bw2012/pk-hobbit/docs/sys/03.gif

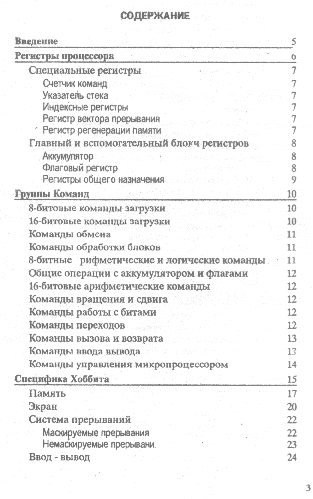
docs/sys/03.gif
