bw2012/pk-hobbit/docs/sys/04_05.gif

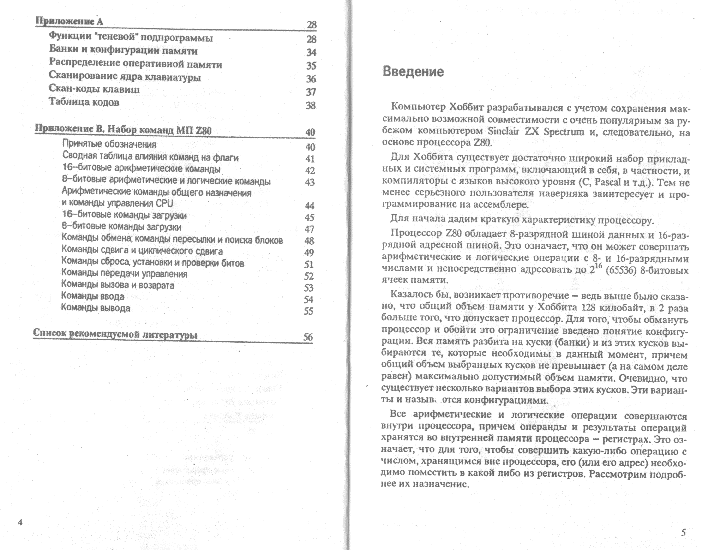
docs/sys/04_05.gif
