bw2012/pk-hobbit/docs/sys/06_07.gif

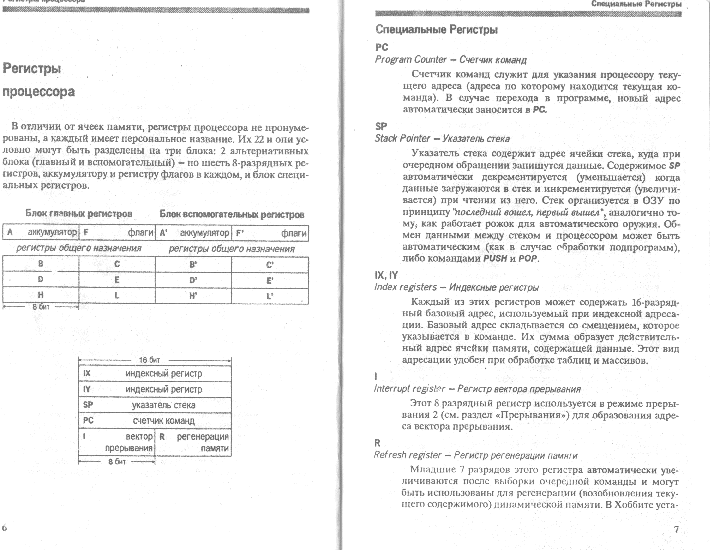
docs/sys/06_07.gif
