bw2012/pk-hobbit/docs/sys/08_09.gif

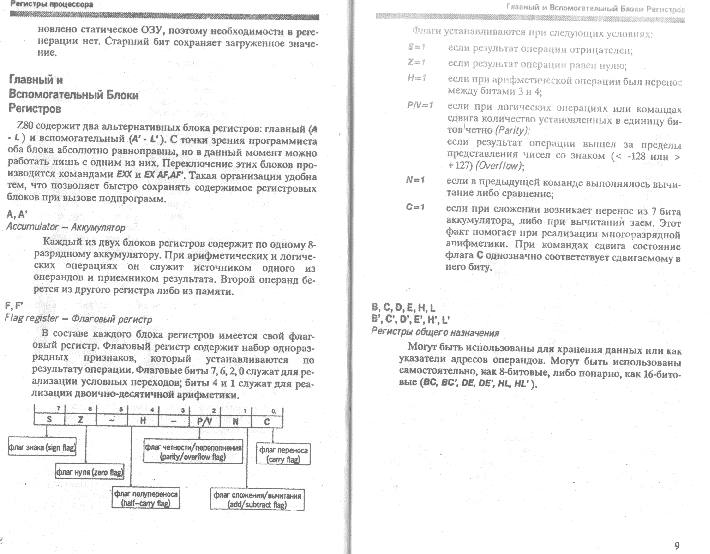
docs/sys/08_09.gif
