bw2012/pk-hobbit/docs/sys/10_11.gif

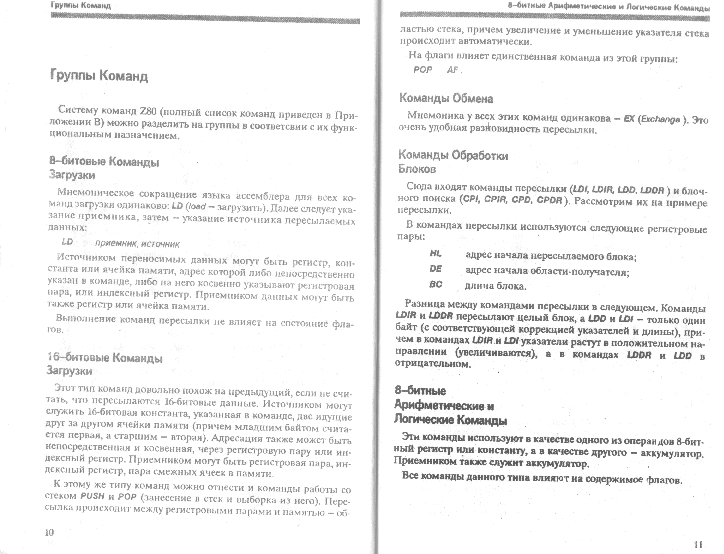
docs/sys/10_11.gif
