bw2012/pk-hobbit/docs/sys/12_13.gif

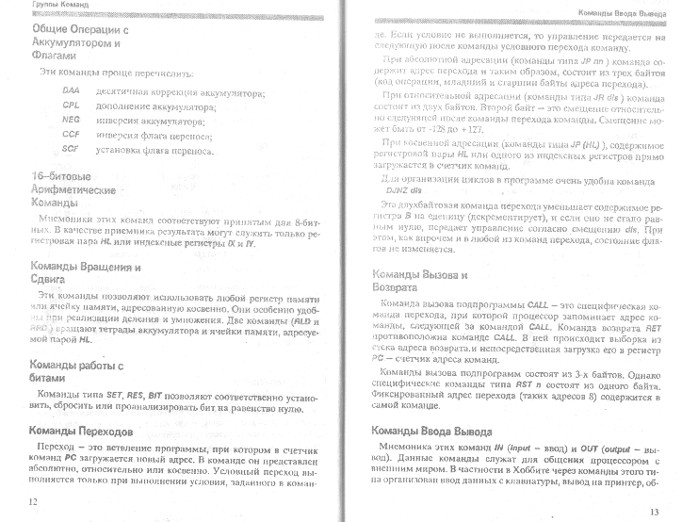
docs/sys/12_13.gif
