bw2012/pk-hobbit/docs/sys/14_15.gif

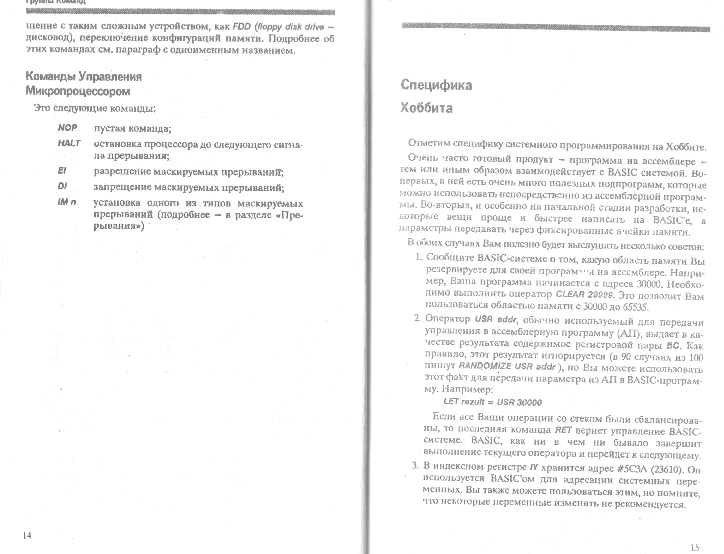
docs/sys/14_15.gif
