bw2012/pk-hobbit/docs/sys/16_17.gif

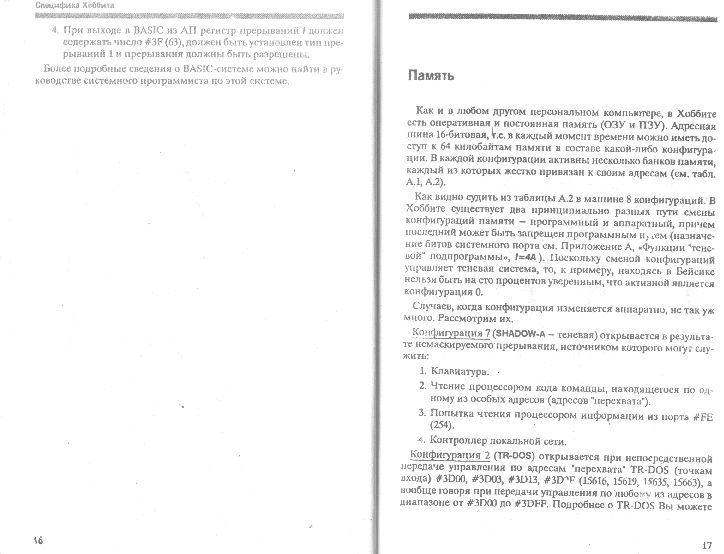
docs/sys/16_17.gif
