bw2012/pk-hobbit/docs/sys/18_19.gif

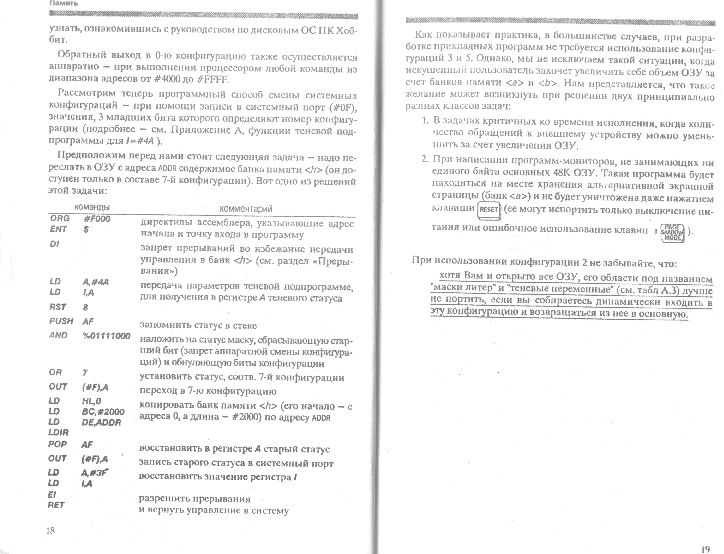
docs/sys/18_19.gif
