bw2012/pk-hobbit/docs/sys/20_21.gif

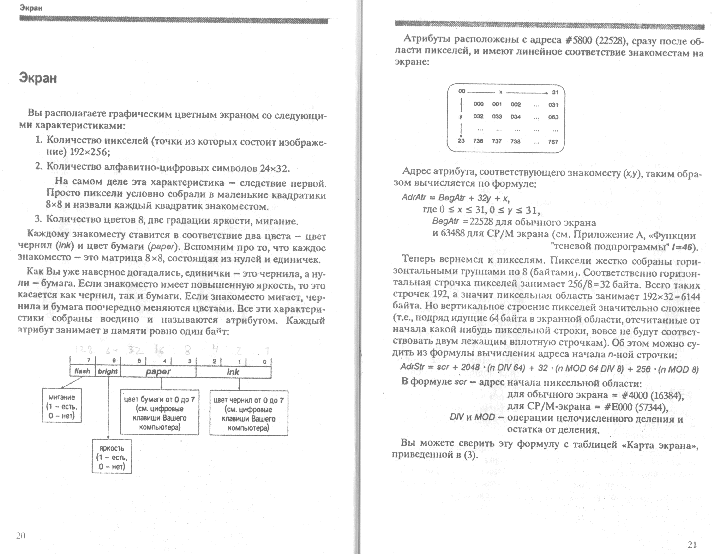
docs/sys/20_21.gif
