bw2012/pk-hobbit/docs/sys/22_23.gif

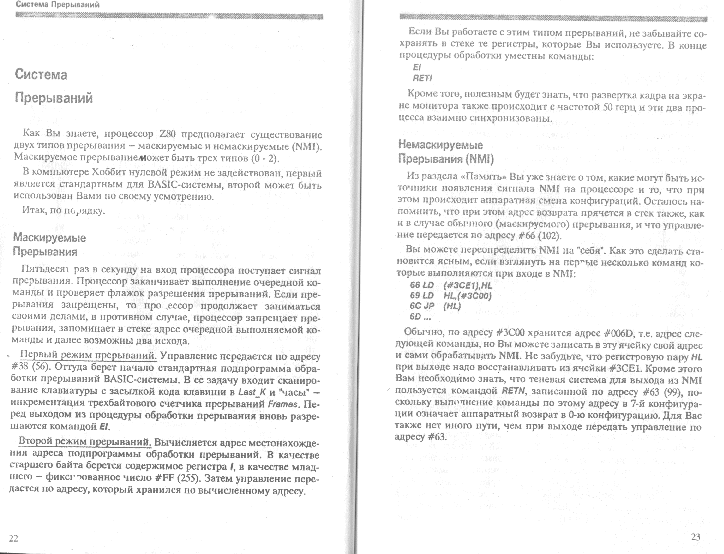
docs/sys/22_23.gif
