bw2012/pk-hobbit/docs/sys/24_25.gif

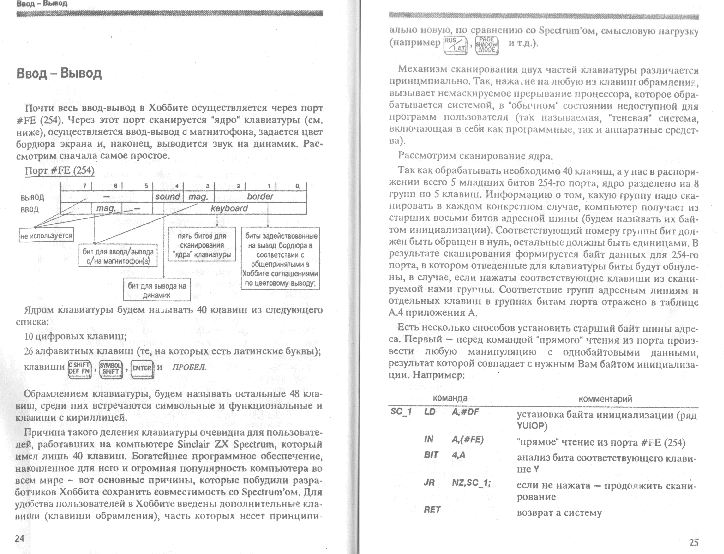
docs/sys/24_25.gif
