bw2012/pk-hobbit/docs/sys/26_27.gif

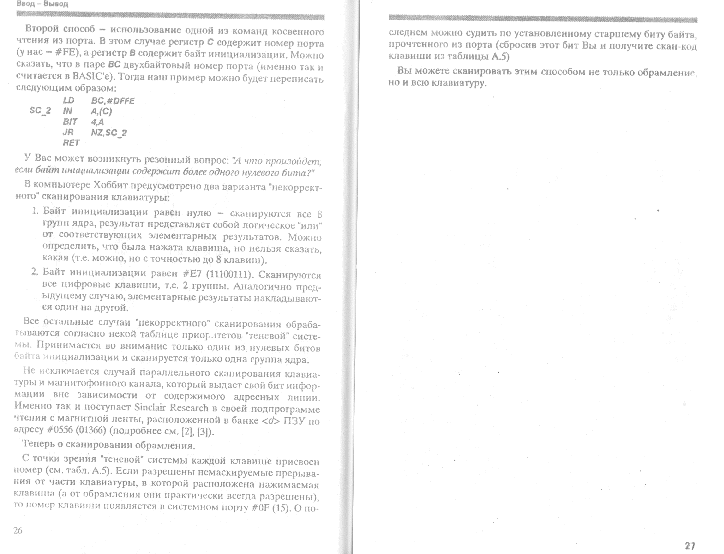
docs/sys/26_27.gif
