bw2012/pk-hobbit/docs/sys/28_29.gif

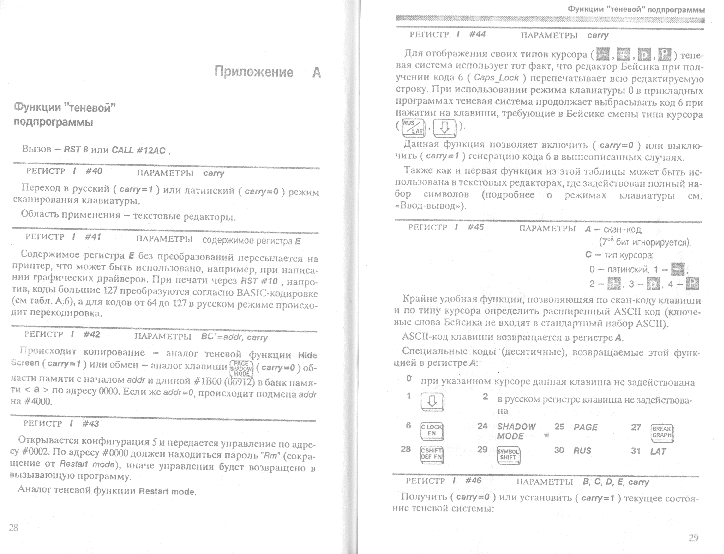
docs/sys/28_29.gif
