bw2012/pk-hobbit/docs/sys/30_31.gif

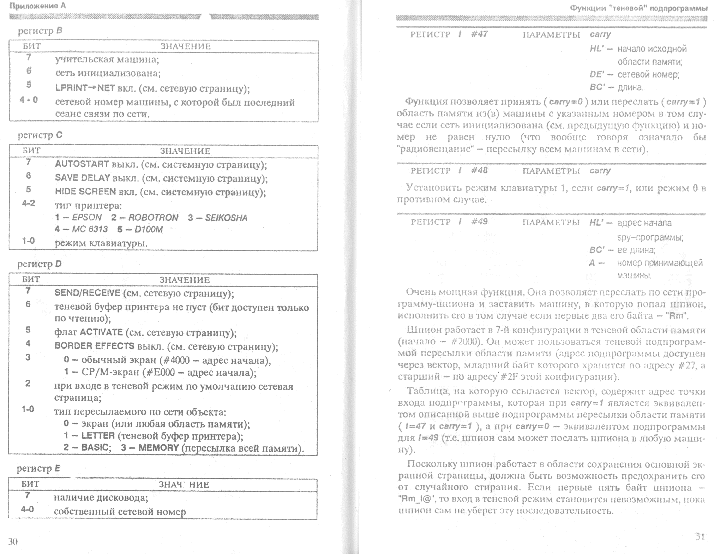
docs/sys/30_31.gif
