bw2012/pk-hobbit/docs/sys/32_33.gif

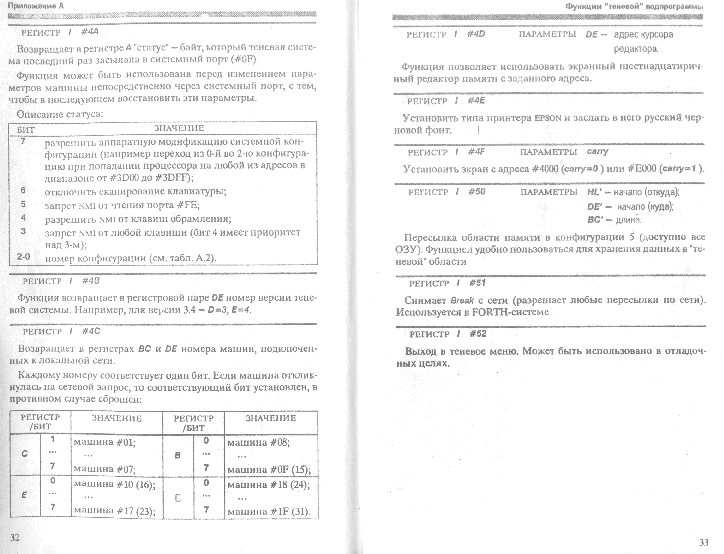
docs/sys/32_33.gif
