bw2012/pk-hobbit/docs/sys/34_35.gif

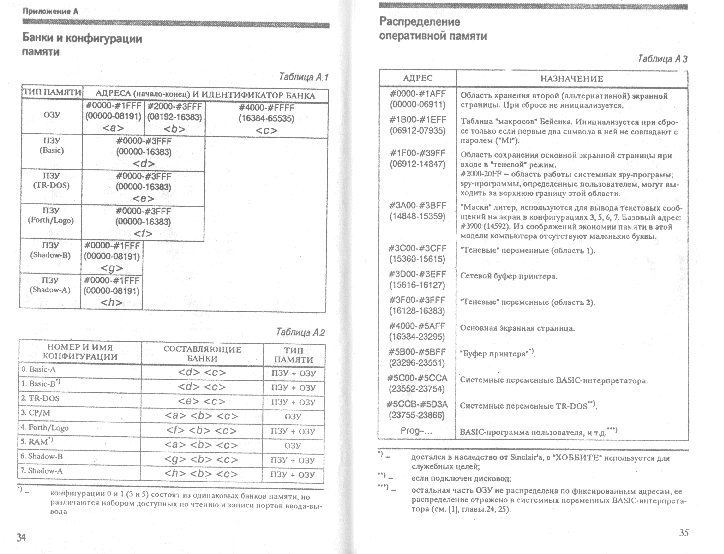
docs/sys/34_35.gif
