bw2012/pk-hobbit/docs/sys/36_37.gif

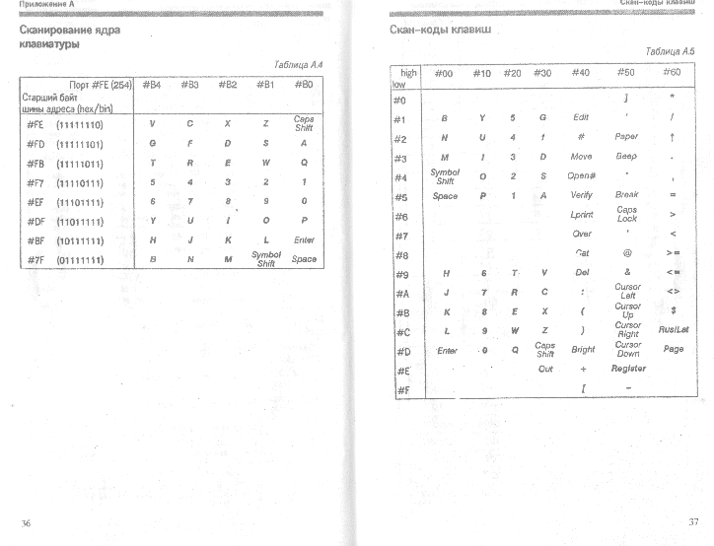
docs/sys/36_37.gif
