bw2012/pk-hobbit/docs/sys/38_39.gif

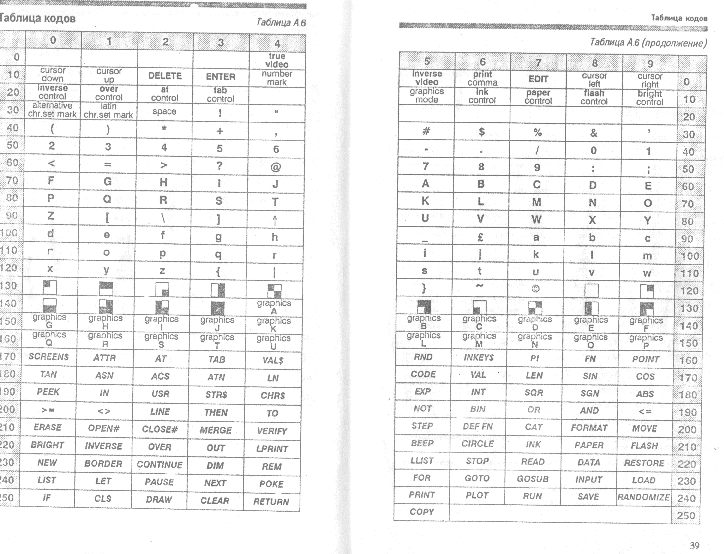
docs/sys/38_39.gif
