bw2012/pk-hobbit/docs/sys/title.gif

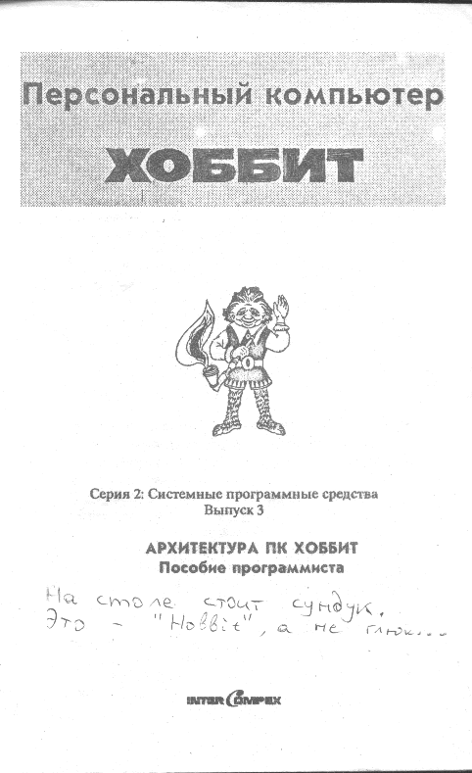
docs/sys/title.gif
