bw2012/pk-hobbit/pcb/1.pdf

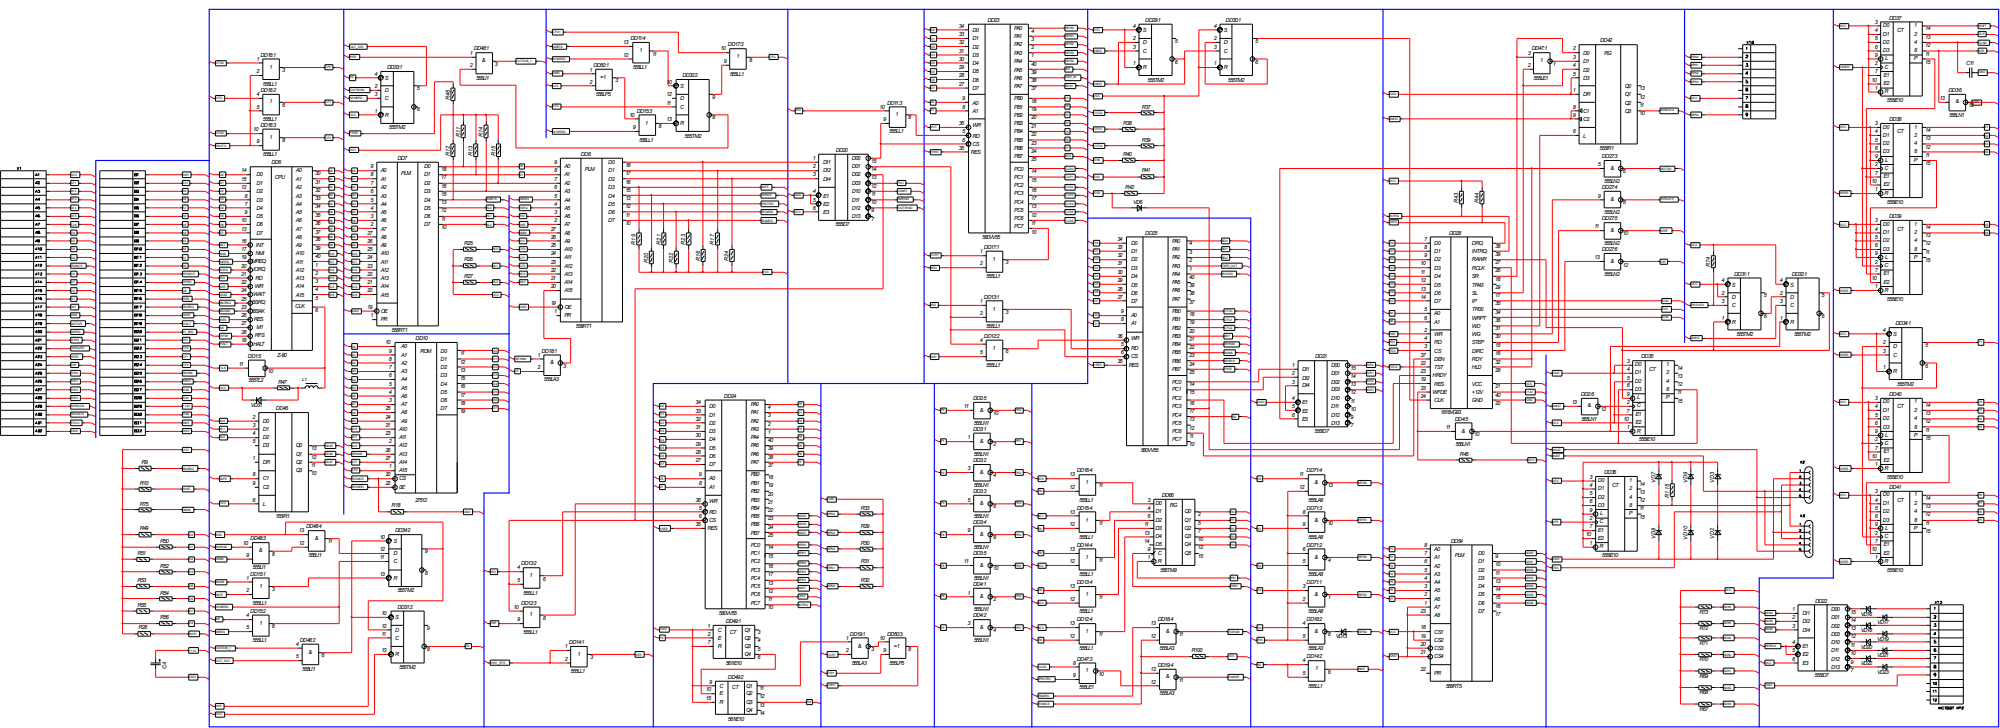
[picture p27: page 1]
