bw2012/pk-hobbit/pcb/2.pdf

14256

1469

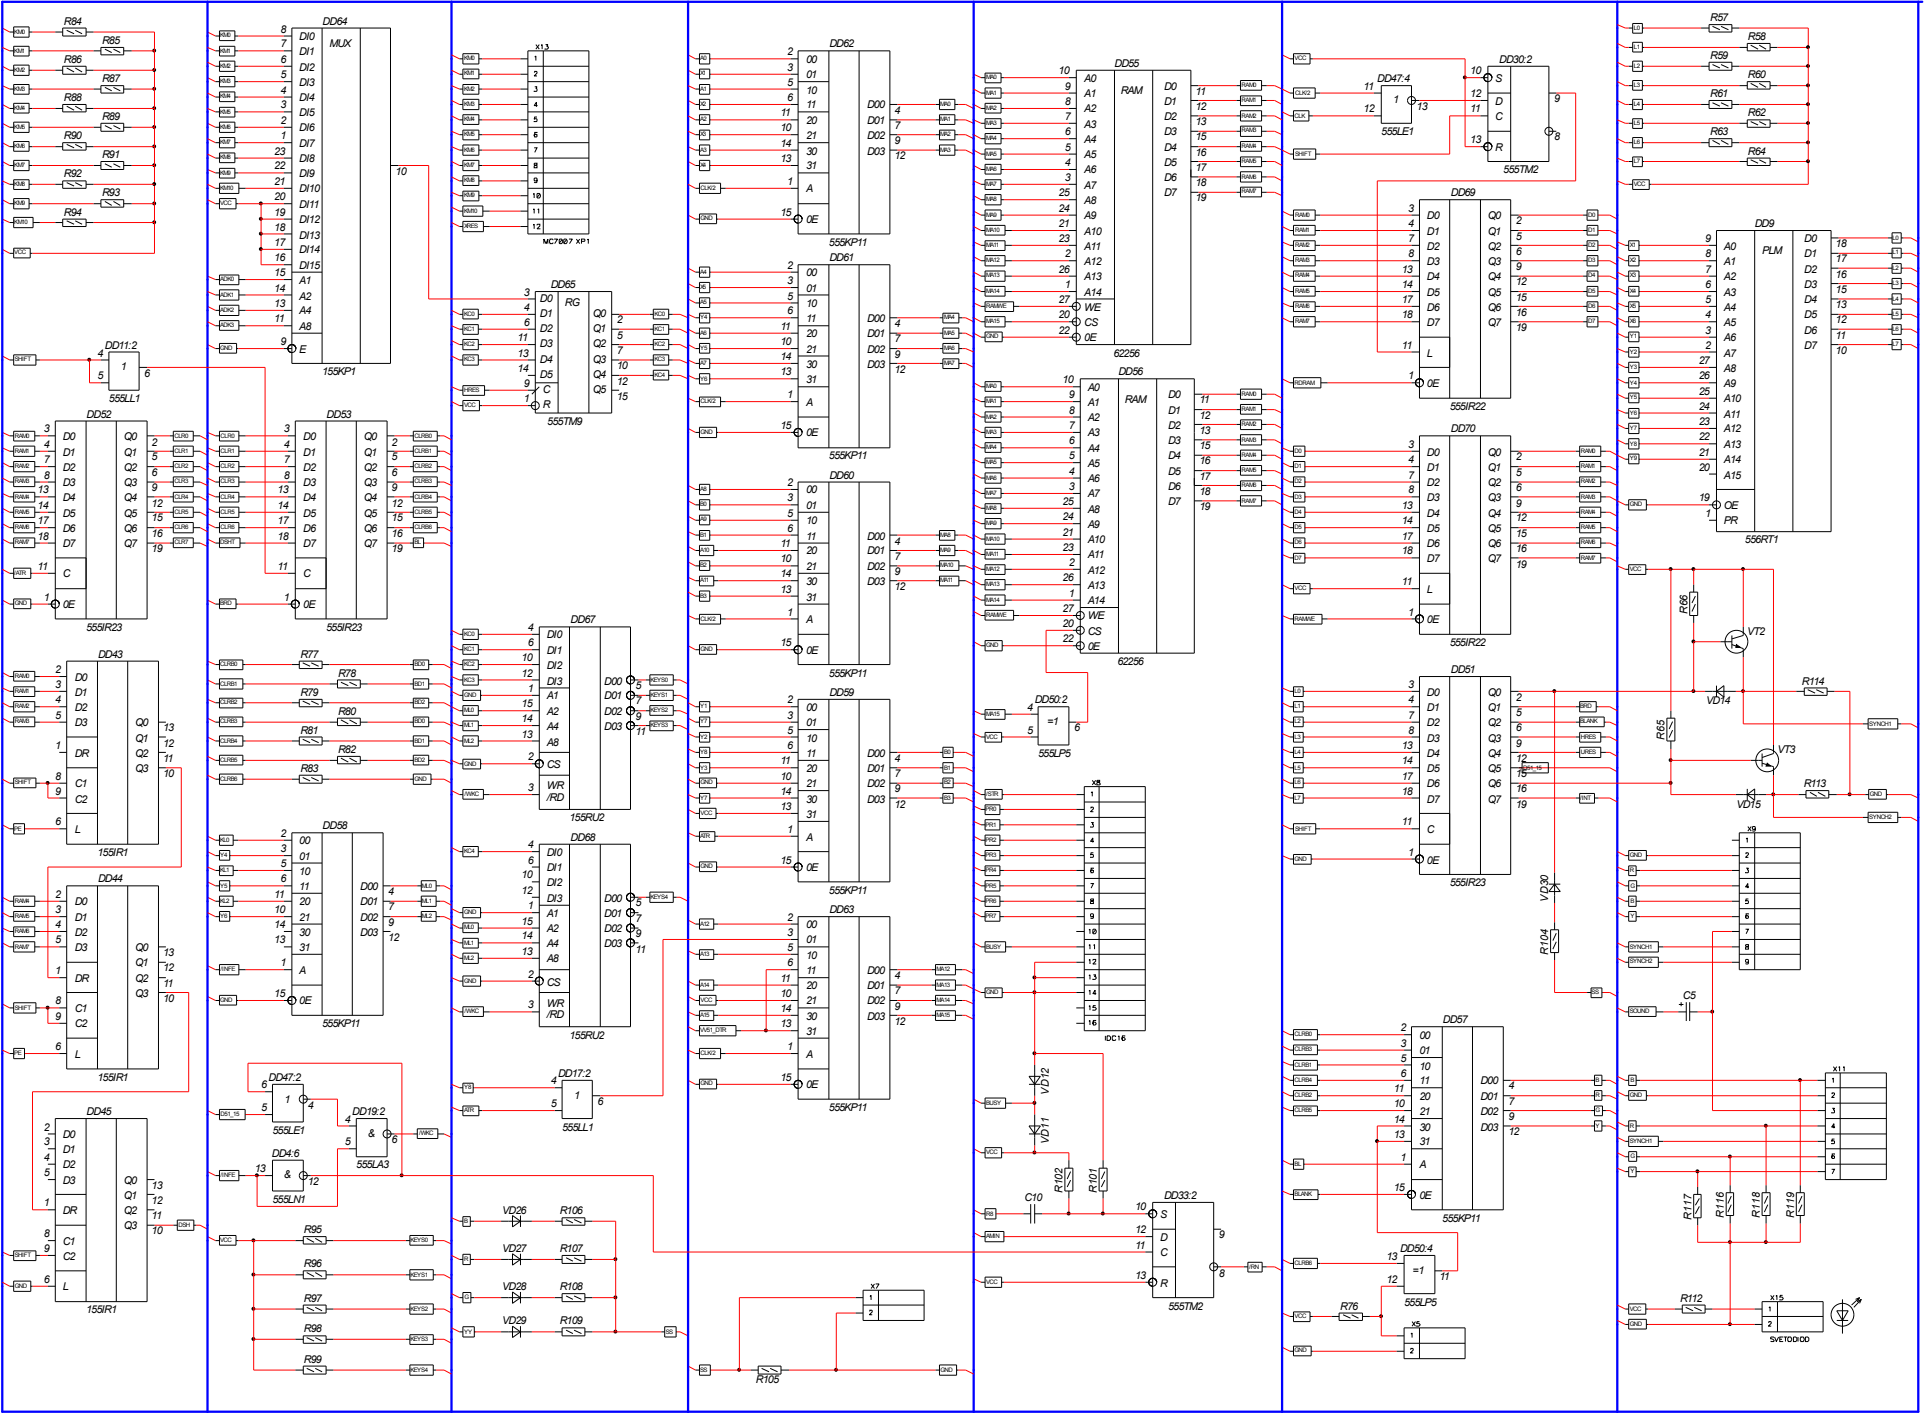
[picture p28: page 1]
