bw2012/pk-hobbit/pcb/3.pdf

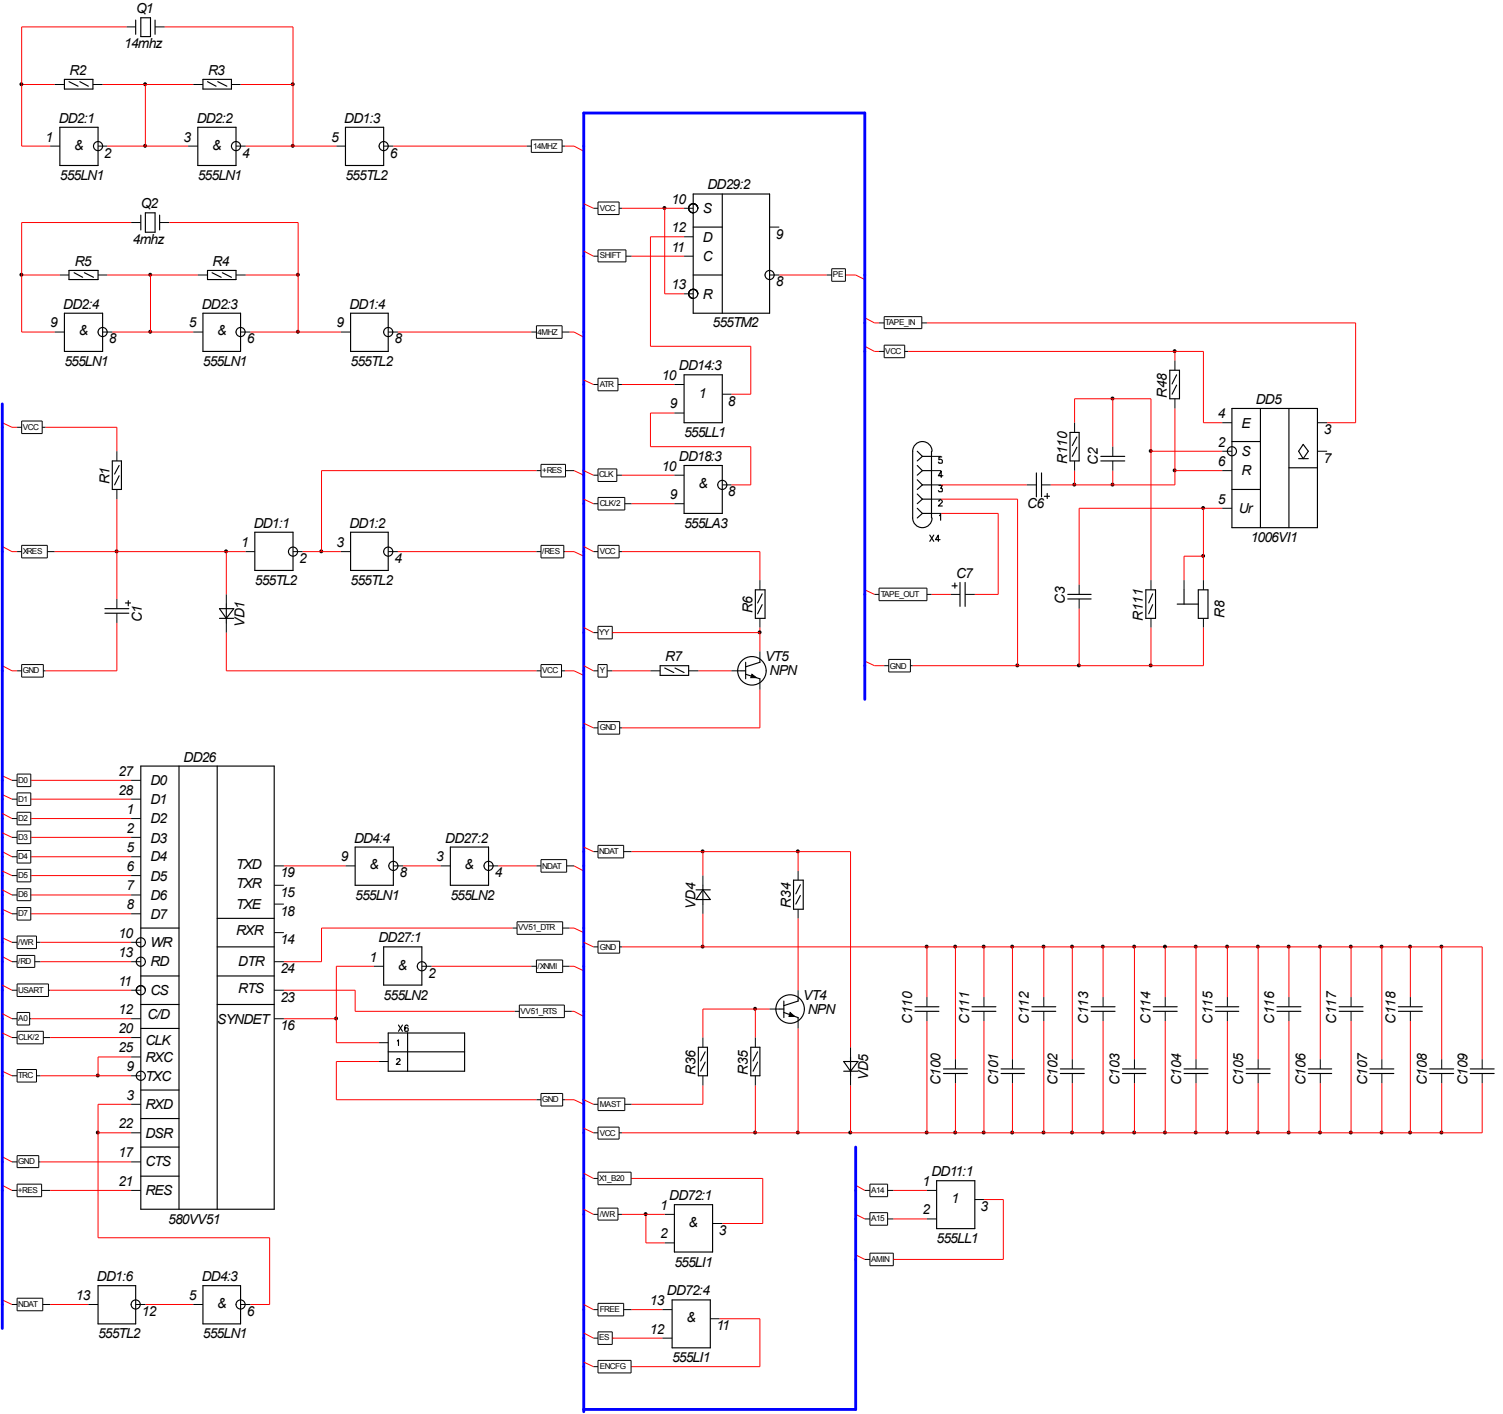
[picture p29: page 1]

D5 | 15 18 | NDAT

USART | 23 | 555LN2
