bw2012/pk-hobbit/pcb/m.pdf

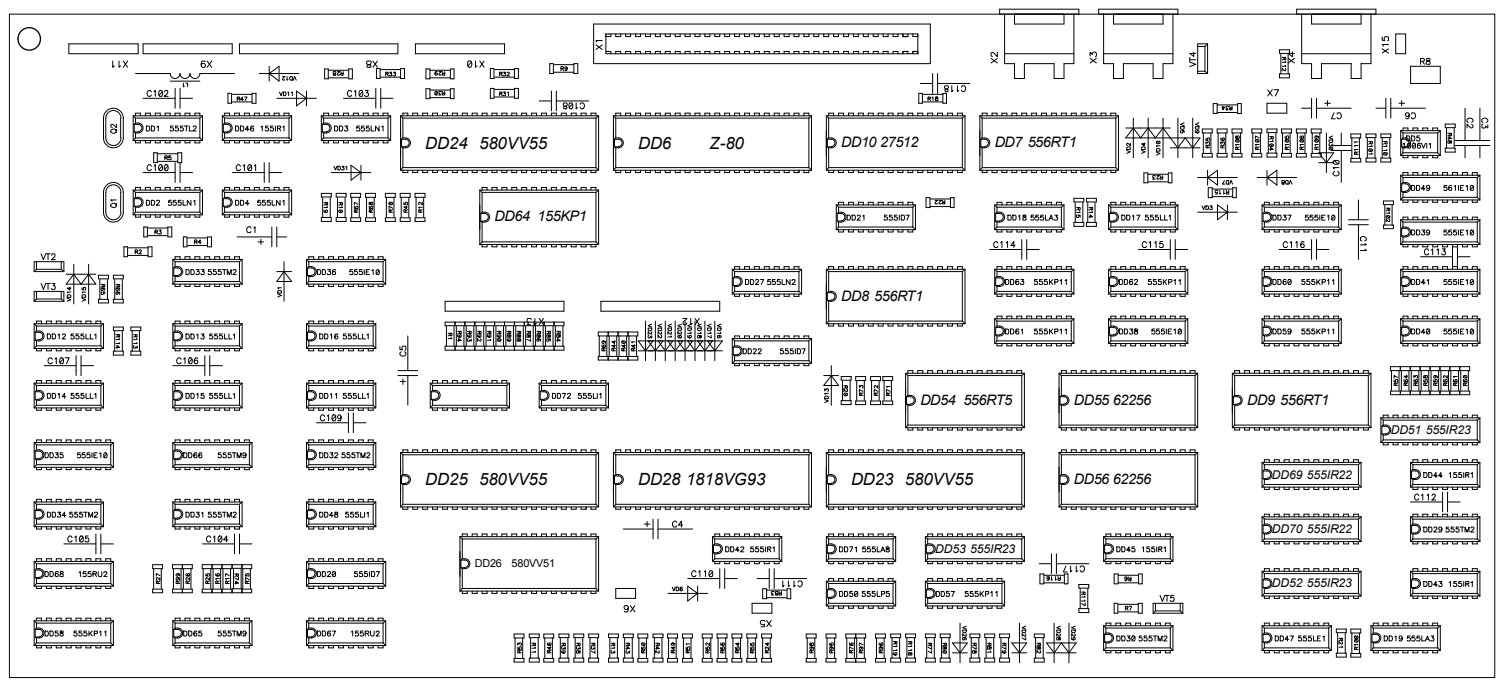
[picture p30: page 1]
