bw2012/pk-hobbit/(list of files, drawings)

Other design files:
pcb/new/hobbit.pcb
